MatthewBregg/LittleIron/README

An Open Source Nerf Blaster

 - Stepper Driver Controlled
 - Brushless
 - Full hydrostatic profile
 - Compacted

See little_iron_build_guide.org for a build guide.

 "This is not an officially supported Google product"
