MatthewBregg/LittleIron/third party fonts/README

An Open Source Nerf Blaster 

 - Stepper Driver Controlled
 - Brushless
 - Full hydrostatic profile
 - Compacted

Full build/print guide coming soon!
