MatthewBregg/LittleIron/noled_cover.fcstd

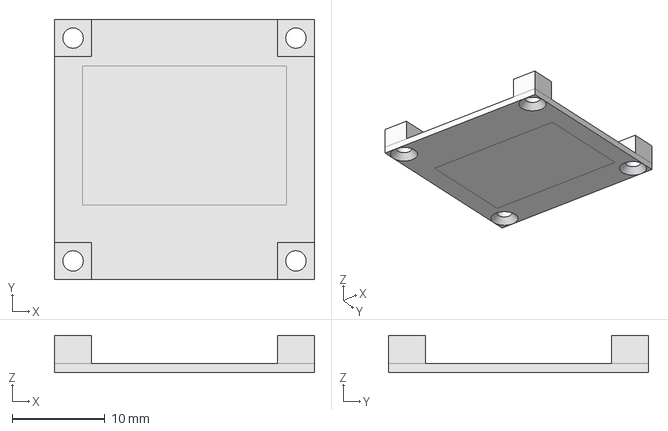
[picture p1: CAD file, 2019-06-12]
noled_cover.fcstd
28.0 x 28.0 x 4.00 mm
