MatthewBregg/LittleIron/battery_door.fcstd

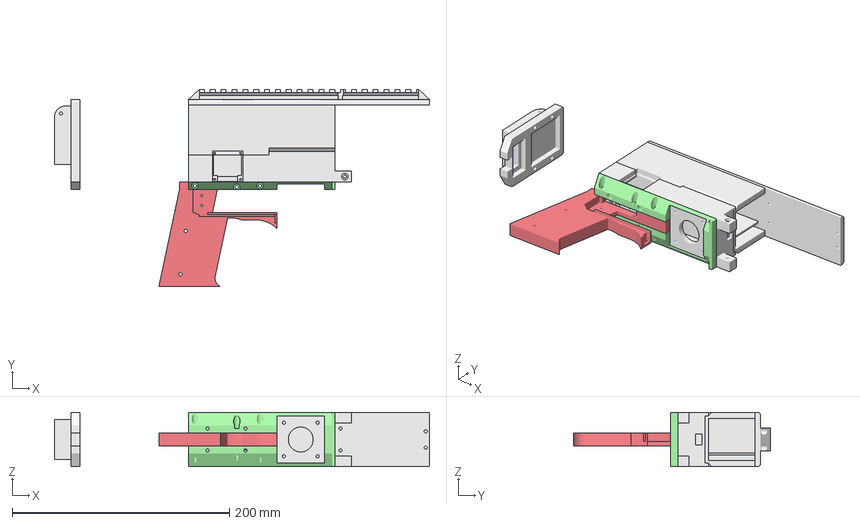
[picture p2: CAD file, 2019-06-08]
battery_door.fcstd
345.4 x 181.7 x 50.0 mm
Battery Door
top
pusher_mount_cover
pusher_mount
handle_mount
handle
