MatthewBregg/LittleIron/spinner.fcstd

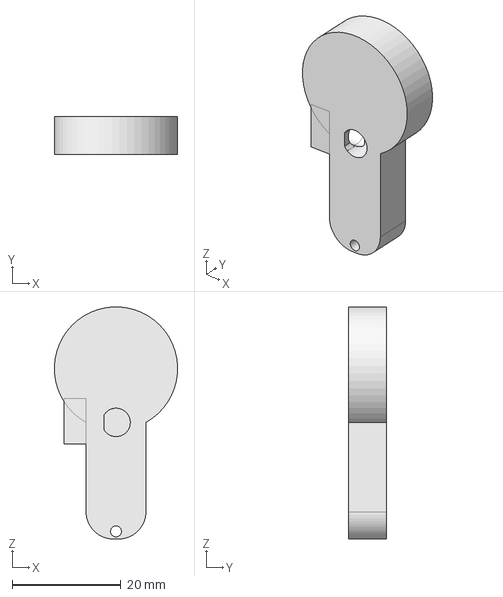
[picture p3: CAD file, 2019-06-03]
spinner.fcstd
22.6 x 7.00 x 42.6 mm
