MatthewBregg/LittleIron/blaster_topper.fcstd

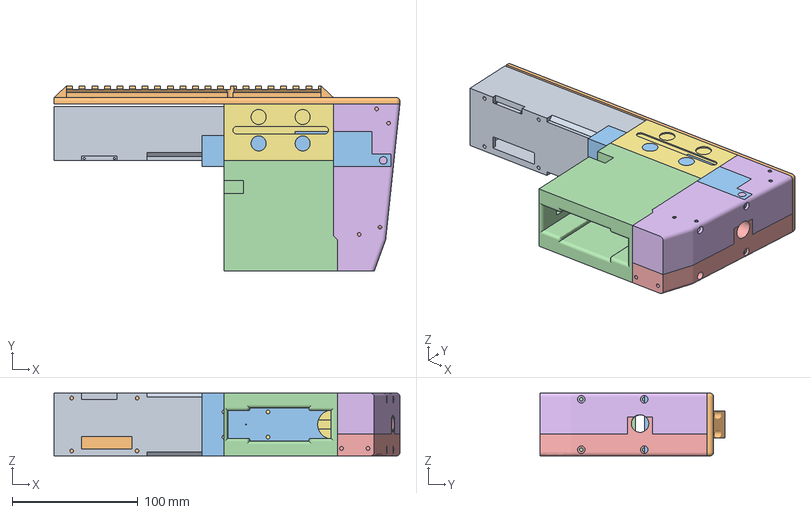
[picture p4: CAD file, 2019-05-28]
blaster_topper.fcstd
274.8 x 147.3 x 50.0 mm
Pusher Mount Cover
Top
Pad007Body
Pocket012Body
fwc
fwc_cover
logic_box
