MatthewBregg/LittleIron/pusher_mount.fcstd

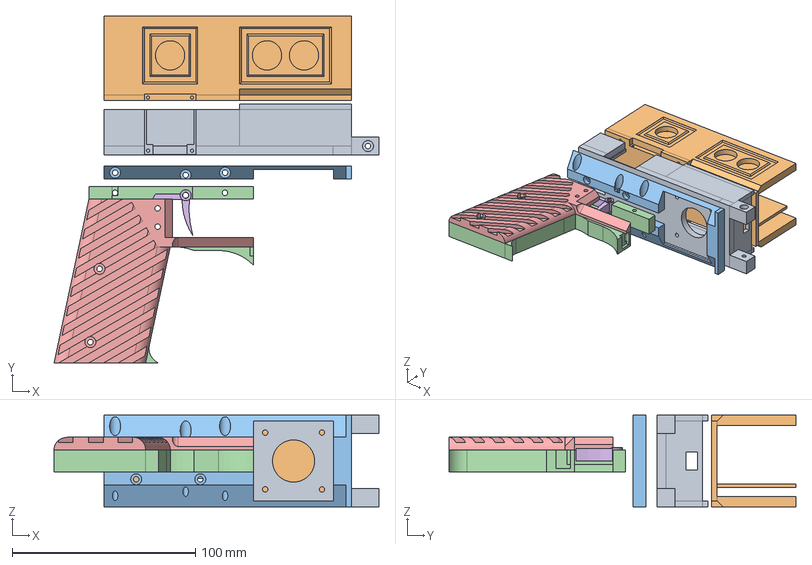
[picture p5: CAD file, 2019-05-23]
pusher_mount.fcstd
177.3 x 189.4 x 50.0 mm
Main mount
Pusher Mount Cover
Handle Mount
New Handle
Right
Trigger Take Two
