MatthewBregg/LittleIron/stepper_motor_cover.fcstd

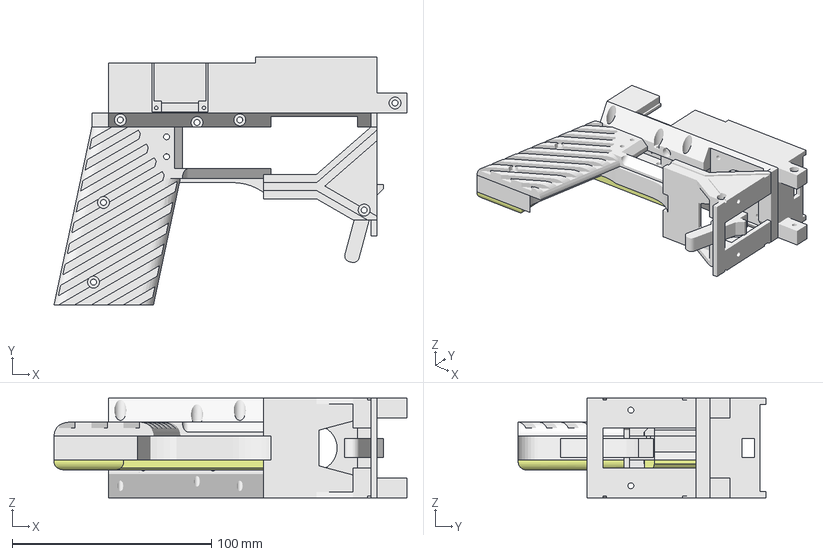
[picture p6: CAD file, 2019-05-22]
stepper_motor_cover.fcstd
177.4 x 124.4 x 50.0 mm
pusher_mount
handle
mag_release_button
left
right002
handle_mount001
