MatthewBregg/LittleIron/magazine_well.fcstd

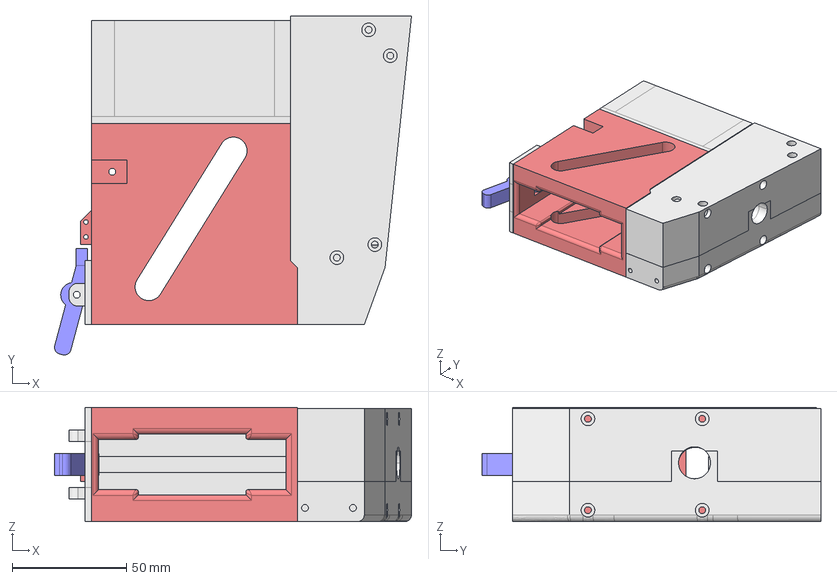
[picture p7: CAD file, 2019-05-14]
magazine_well.fcstd
156.3 x 148.4 x 50.0 mm
Main Magwell
Mag release holder
Mag release
Flywheel Cage
Esc/Logic box
FWC Cover
