MatthewBregg/LittleIron/groove_fillers.fcstd

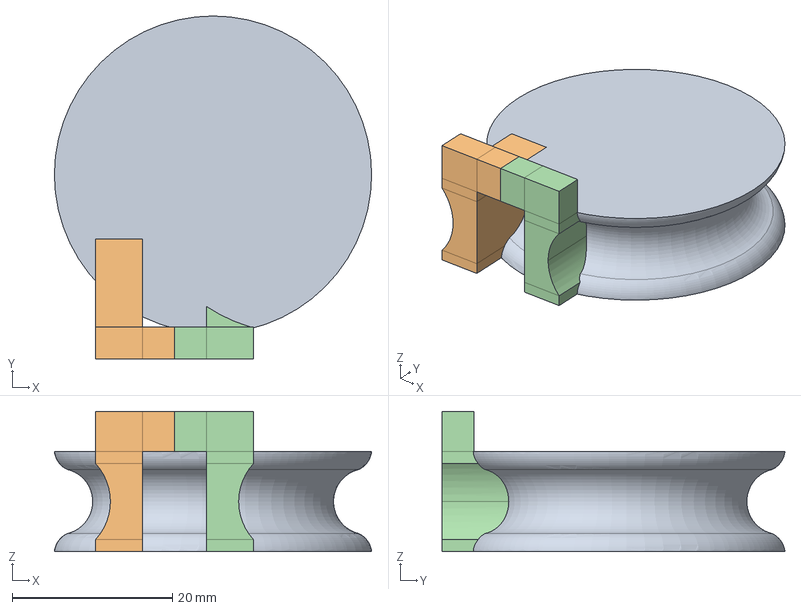
[picture p8: CAD file, 2019-03-18]
groove_fillers.fcstd
39.6 x 42.8 x 17.5 mm
Ultracage wheel
Groovy Fillers
Cut (Mirror #1)
