MatthewBregg/LittleIron/receiver_bottom.fcstd

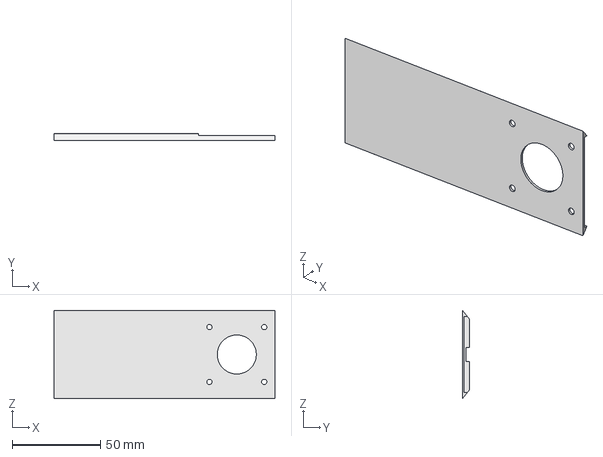
[picture p9: CAD file, 2019-03-05]
receiver_bottom.fcstd
125.0 x 4.00 x 50.0 mm
