MatthewBregg/LittleIron/handle.fcstd

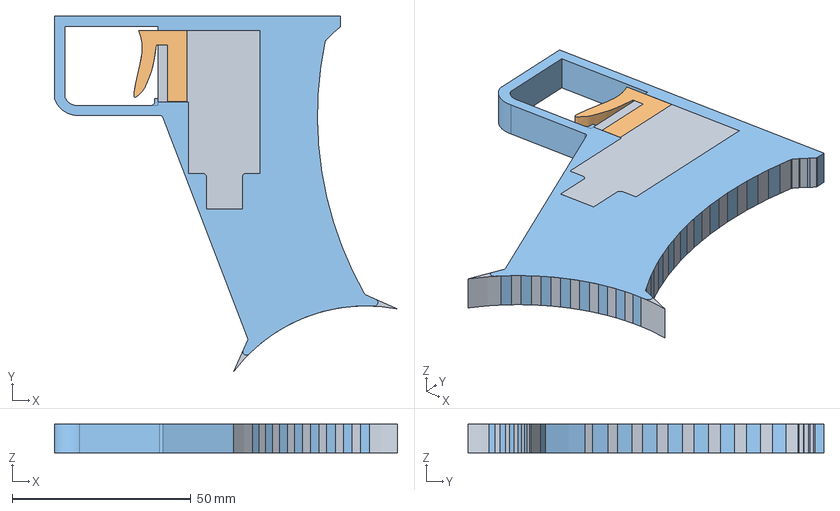
[picture p10: CAD file, 2019-03-05]
handle.fcstd
95.9 x 99.5 x 8.00 mm
Handle
Trigger
