MatthewBregg/LittleIron/bolt.fcstd

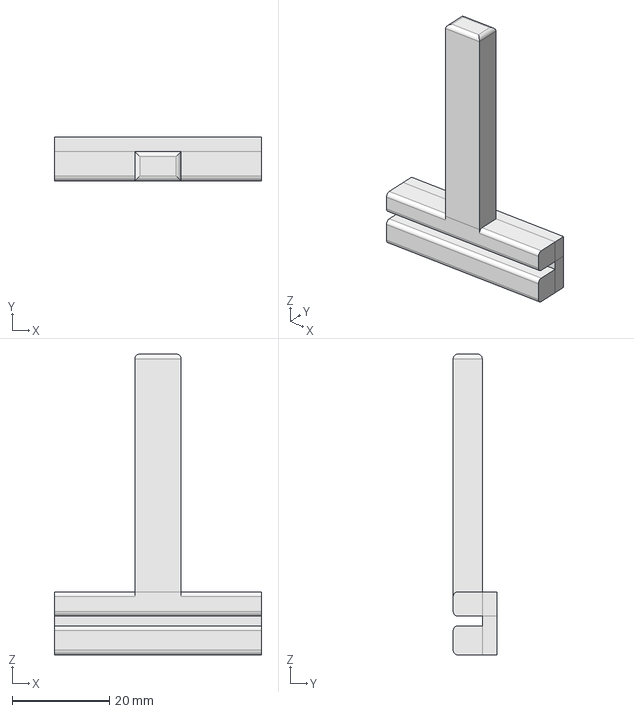
[picture p11: CAD file, 2019-03-28]
bolt.fcstd
42.7 x 9.00 x 62.0 mm
