MatthewBregg/LittleIron/(commit log)

2019-03-02 init git commit
    [handle.fcstd]
2019-03-03 Added a trigger
    [handle.fcstd]
2019-03-04 Receiver done, but stepper in that spot isn't really comfy! Oh no!
    [handle.fcstd, receiver_bottom.fcstd]
2019-03-05 Pusher checkpoint
    [bolt.fcstd, handle.fcstd, pusher_bolt.fcstd, pusher_mount.fcstd, receiver_bottom.fcstd]
2019-03-07 Pusher mount (receiver bottom! Almost done!
    [bolt.fcstd, pusher_mount.fcstd]
2019-03-10 Working pusher unit
    [pusher_mount.fcstd]
2019-03-11 Working magwell
    [magazine_well.fcstd, pusher_mount.fcstd]
2019-03-11 Beginning mag holder
    [magazine_well.fcstd]
2019-03-17 Moar magweelllll progreasd
    [magazine_well.fcstd]
2019-03-18 FWG progress
    [magazine_well.fcstd]
2019-03-18 Added example dart, confirmed flywheels are correct vertical alignment
    [magazine_well.fcstd]
2019-03-18 Starting groove fillers
    [groove_fillers.fcstd, magazine_well.fcstd]
2019-03-18 more groove fillers
    [groove_fillers.fcstd]
2019-03-18 groove fillers done
    [groove_fillers.fcstd]
2019-03-18 Groove fillers aren't fucking working in freecad, I give up...
    [groove_fillers.fcstd]
2019-03-18 Added flywheels onto spot
    [magazine_well.fcstd]
2019-03-19 Wheels added, starting work on groove filelrs take 2
    [magazine_well.fcstd]
2019-03-19 Possible working Groove Fillers?git add .
    [magazine_well.fcstd]
2019-03-19 More FWC progress
    [magazine_well.fcstd]
2019-03-19 Extended GFs
    [magazine_well.fcstd]
2019-03-19 More GF.
    [magazine_well.fcstd]
2019-03-23 Added wire raceways
    [magazine_well.fcstd]
2019-03-24 Magwell state 03/24
    [magazine_well.fcstd]
2019-03-24 Moved dart exit hole up!
    [magazine_well.fcstd]
2019-03-24 Increased motor hole size for center pin
    [magazine_well.fcstd]
2019-03-25 Top feed guide added
    [magazine_well.fcstd]
2019-03-25 Top feed guide added p2
    [magazine_well.fcstd]
2019-03-26 Named pusher mount sketches
    [magazine_well.fcstd, pusher_mount.fcstd]
2019-03-27 Redid sidewall deminsions, and crank top.
    [bolt.fcstd, pusher_bolt.fcstd, pusher_mount.fcstd]
2019-03-27 New bolt done
    [bolt.fcstd, pusher_mount.fcstd]
2019-03-27 Adjusted limit switch positioning
    [bolt.fcstd, pusher_mount.fcstd]
2019-03-27 Adjusted pusher mount
    [pusher_mount.fcstd]
2019-03-27 Adjusted pusher mount, changed mag arm interface
    [pusher_mount.fcstd]
2019-03-27 Added magazine arm screw holes
    [magazine_well.fcstd]
2019-03-27 Modified the pusher mount to have screw holes
    [pusher_mount.fcstd]
2019-03-27 Extended the pusher body to have taller sidewalls
    [pusher_mount.fcstd]
2019-03-28 Extended side walls
    [pusher_mount.fcstd]
2019-03-28 Updated bolt for new sidewall width of 43.5, and decreased height by 1 mm (elevation 4mm -> 3mm).
    [bolt.fcstd]
2019-03-28 REnamed pusher bolt to spinner
    [spinner.fcstd]
2019-03-29 Started pusher topper
    [pusher_mount.fcstd]
2019-03-29 Updated screw pattern
    [pusher_mount.fcstd]
2019-03-29 Added wire dividing hole
    [pusher_mount.fcstd]
2019-03-29 Redid height
    [pusher_mount.fcstd]
2019-03-29 Rear screw holes
    [pusher_mount.fcstd]
2019-03-29 Added chamfer to bottom
    [pusher_mount.fcstd]
2019-03-29 Oops, fixed fucked screw holes
    [pusher_mount.fcstd]
2019-03-30 REturning to the handle
    [pusher_mount.fcstd]
2019-03-30 Work on handle
    [pusher_mount.fcstd]
2019-03-30 About to redo wires
    [pusher_mount.fcstd]
2019-03-31 Take 2 at a handle
    [pusher_mount.fcstd]
2019-04-01 Handle trigger guard beginning
    [pusher_mount.fcstd]
2019-04-01 Now trim the handle guard
    [pusher_mount.fcstd]
2019-04-01 Better sketch naming
    [pusher_mount.fcstd]
2019-04-01 Added top wire guide
    [pusher_mount.fcstd]
2019-04-01 Daily checkpoint?
    [pusher_mount.fcstd]
2019-04-01 Added new wire exit rectangle
    [pusher_mount.fcstd]
2019-04-01 Entry hole expando once again
    [pusher_mount.fcstd]
2019-04-03 ADded side grip right
    [pusher_mount.fcstd]
2019-04-03 HAndle sketch was fucked, attempted to unfuck.
    [pusher_mount.fcstd]
2019-04-04 Extended pusher
    [pusher_mount.fcstd]
2019-04-04 Added side grip screw holes
    [pusher_mount.fcstd]
2019-04-05 Readjusted screw holes on handle to align
    [pusher_mount.fcstd]
2019-04-05 Added more support for screw holes
    [pusher_mount.fcstd]
2019-04-06 :wq Added more handle area wire room
    [pusher_mount.fcstd]
2019-04-07 Initial trigger design
    [pusher_mount.fcstd]
2019-04-08 Moved screw holes back
    [pusher_mount.fcstd]
2019-04-08 Finished moving trigger back
    [pusher_mount.fcstd]
2019-04-08 Added wheel STL/source
    [Ultracage_with_groove_fillers.stl]
2019-04-09 Added mounting pad
    [magazine_well.fcstd]
2019-04-09 Added mounting pad for detecting if magazine is in
    [magazine_well.fcstd]
2019-04-14 Oled screen mount
    [pusher_mount.fcstd]
2019-04-14 Added nut holes to oled screen mount
    [pusher_mount.fcstd]
2019-04-14 Lowered oled 1.5mm
    [pusher_mount.fcstd]
2019-04-14 Lowered oled
    [pusher_mount.fcstd]
2019-04-16 Created oled cover attempt 1
    [oled_cover.fcstd]
2019-04-19 Extend oled wire channel
    [pusher_mount.fcstd]
2019-04-20 Checkpoint 2019-04-20
    [pusher_mount.fcstd]
2019-04-21 Pusher mounter larger wire hole
    [pusher_mount.fcstd]
2019-04-21 Magazine well increase front screw port depth to 10 mm
    [magazine_well.fcstd]
2019-04-22 Trigger width right, but trigger travel/holes too short/small
    [pusher_mount.fcstd]
2019-04-22 Trying .1 mm larger trigger holes and .8mm longer trigger track
    [pusher_mount.fcstd]
2019-04-22 Trigger height 7.9mm @.2mm (no sanding, and 7.8 effective) is a nice fit, with acceptable wobble.
    But this setup requires a spring, as the trigger very much gets stuck even with no screws.
    Trying 7.7 for a tiny bit more leeway, with another idea being sanding for smoothness?
    At the very least, the screw appears to go cleanly through the trigger hole.
    [pusher_mount.fcstd]
2019-04-26 Attempting to cosmetically improve FWC
    [magazine_well.fcstd]
2019-04-26 Extend dart barrel
    [magazine_well.fcstd]
2019-04-26 FWC revamp take 1 completish
    [magazine_well.fcstd]
2019-04-26 FWC revamp take2: Add a platform to make the cage more even.
    [magazine_well.fcstd]
2019-04-26 Extended FWC downwards
    [magazine_well.fcstd]
2019-04-26 Added a chafer to the FWC sides
    [magazine_well.fcstd]
2019-04-27 Experimenting with a new trigger design
    [pusher_mount.fcstd]
2019-04-27 Added a pivot hole for the trigger to the handle
    [pusher_mount.fcstd]
2019-04-27 Updated trigger, but overall seems to be a very good fit!
    [pusher_mount.fcstd]
2019-04-27 Added pivot hole to the handle mount
    [pusher_mount.fcstd]
2019-04-27 Added a flashlight recess and mount pattern to the FWC
    [magazine_well.fcstd]
2019-05-02 Beginning work on topper
    [blaster_topper.fcstd]
2019-05-03 More progress on the top
    [blaster_topper.fcstd]
2019-05-03 Extended the pusher cover to match the logic box
    [blaster_topper.fcstd, pusher_mount.fcstd]
2019-05-04 HAndle right add switch screw indenties
    [pusher_mount.fcstd]
2019-05-04 Battery door basic done
    [battery_door.fcstd]
2019-05-04 Added a .35 offset to the feed guide.
    Nerf darts are 12.7mm. My feed guide was 6.35 above, but nerf darts compress down to 6 in a magazine.
    So account for that with a .35 offset.
    [battery_door.fcstd, magazine_well.fcstd]
2019-05-04 First attempt at a fwc cover
    [magazine_well.fcstd]
2019-05-04 Added info on where to get m30 threading I will be using for the stock/buttplate
2019-05-04 FWC TOP modifications, needed more wheel clearence, and slightly too thick.
    [magazine_well.fcstd]
2019-05-05 FWC Cover shorten 1/2 an mm.
    [magazine_well.fcstd]
2019-05-05 Attempting a stepper motor cover/mag release combo
    [stepper_motor_cover.fcstd]
2019-05-05 Extended magazine arm
    [magazine_well.fcstd, stepper_motor_cover.fcstd]
2019-05-05 Stepper motor cover/magwell mostly done
    [stepper_motor_cover.fcstd]
2019-05-05 Stepper motor cover a bit fugly, but functionally I think is donegit add .!
    [stepper_motor_cover.fcstd]
2019-05-06 Update to stepper motor cover
    [stepper_motor_cover.fcstd]
2019-05-11 Checkpoint may 11
    [pusher_mount.fcstd, stepper_motor_cover.fcstd]
2019-05-11 Extended handle to 50 mm
    [pusher_mount.fcstd]
2019-05-12 Extended handle cover to the hole thing
    [pusher_mount.fcstd]
2019-05-12 Improved handle pad designs
    [pusher_mount.fcstd, stepper_motor_cover.fcstd]
2019-05-14 Remove flywheel windows from FWC, they ugly
    [magazine_well.fcstd]
2019-05-14 Added magazine dart view window mababoby
    [magazine_well.fcstd]
2019-05-16 Added stripes to handle
    [pusher_mount.fcstd]
2019-05-16 Take 2 at stripes to handle
    [pusher_mount.fcstd]
2019-05-16 Stepper motor cover trimmed
    [stepper_motor_cover.fcstd]
2019-05-16 Stepper motor decals are done!
    [stepper_motor_cover.fcstd]
2019-05-22 Triangilized the handle base
    [pusher_mount.fcstd]
2019-05-22 Updated stepper motor cover assembly
    [pusher_mount.fcstd, stepper_motor_cover.fcstd]
2019-05-22 Battery door work some more!
    [battery_door.fcstd]
2019-05-23 Added a pattern onto the battery box
    [pusher_mount.fcstd]
2019-05-25 Magwell readded mag release screw ports, oops
2019-05-25 Filletted FWC cover
    [blaster_topper.fcstd]
2019-05-25 Extended blaster topper
    [blaster_topper.fcstd]
2019-05-25 Adjusted FWC thickness
    [blaster_topper.fcstd]
2019-05-25 Updated topper to cover whole blaster
    [blaster_topper.fcstd]
2019-05-28 Added front screw ports fwc cage
    [blaster_topper.fcstd]
2019-06-03 Spinner update
    [spinner.fcstd]
2019-06-08 Updated battery door
    [battery_door.fcstd]
2019-06-12 Add a blank cover for use without an oled
    [noled_cover.fcstd]
2019-06-13 Build Guide
    [Ultracage_with_groove_fillers.stl]
